nileshdas092006-hash/hardware_lab_shieldv/diagrams/timing_diagram.png

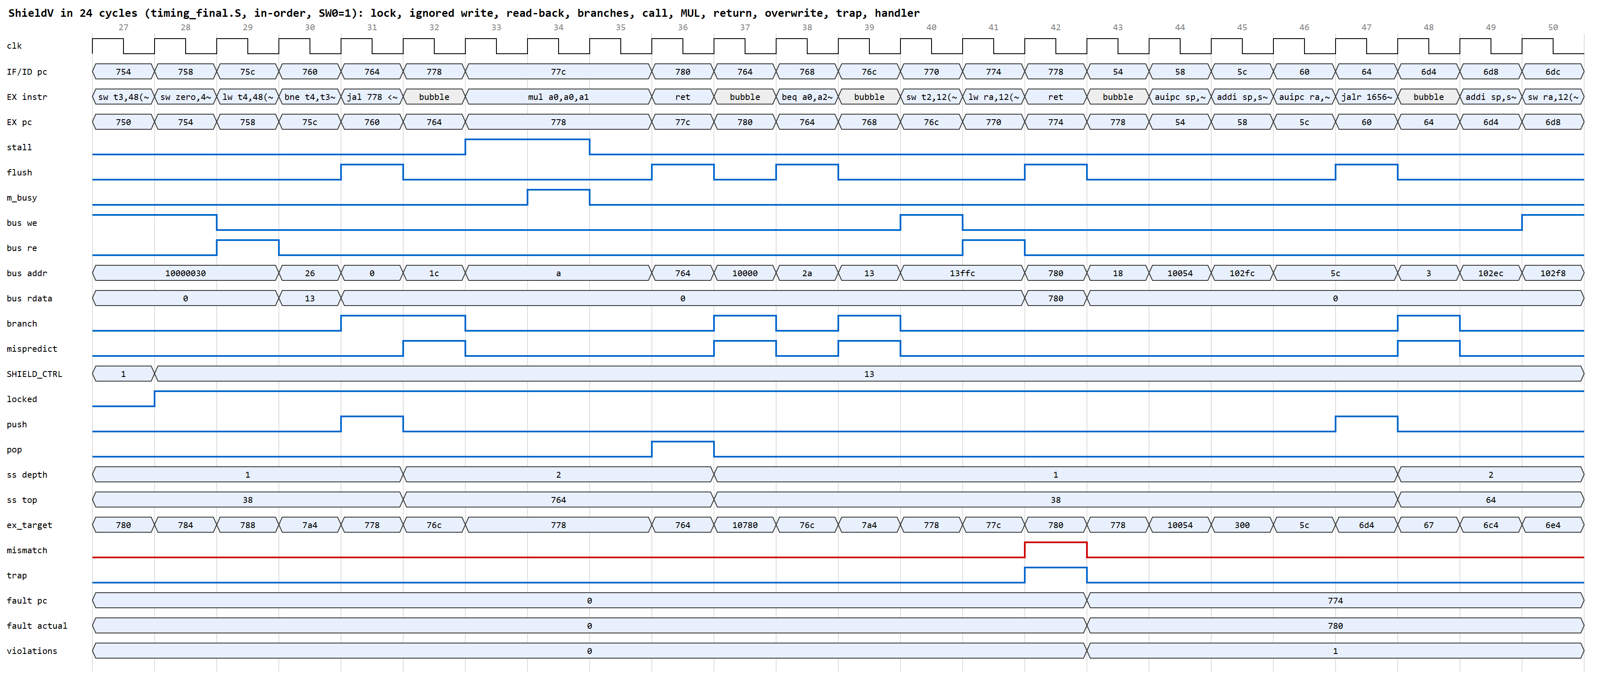
diagrams/timing_diagram.png
