nileshdas092006-hash/hardware_lab_shieldv/diagrams/top_block_diagram.png

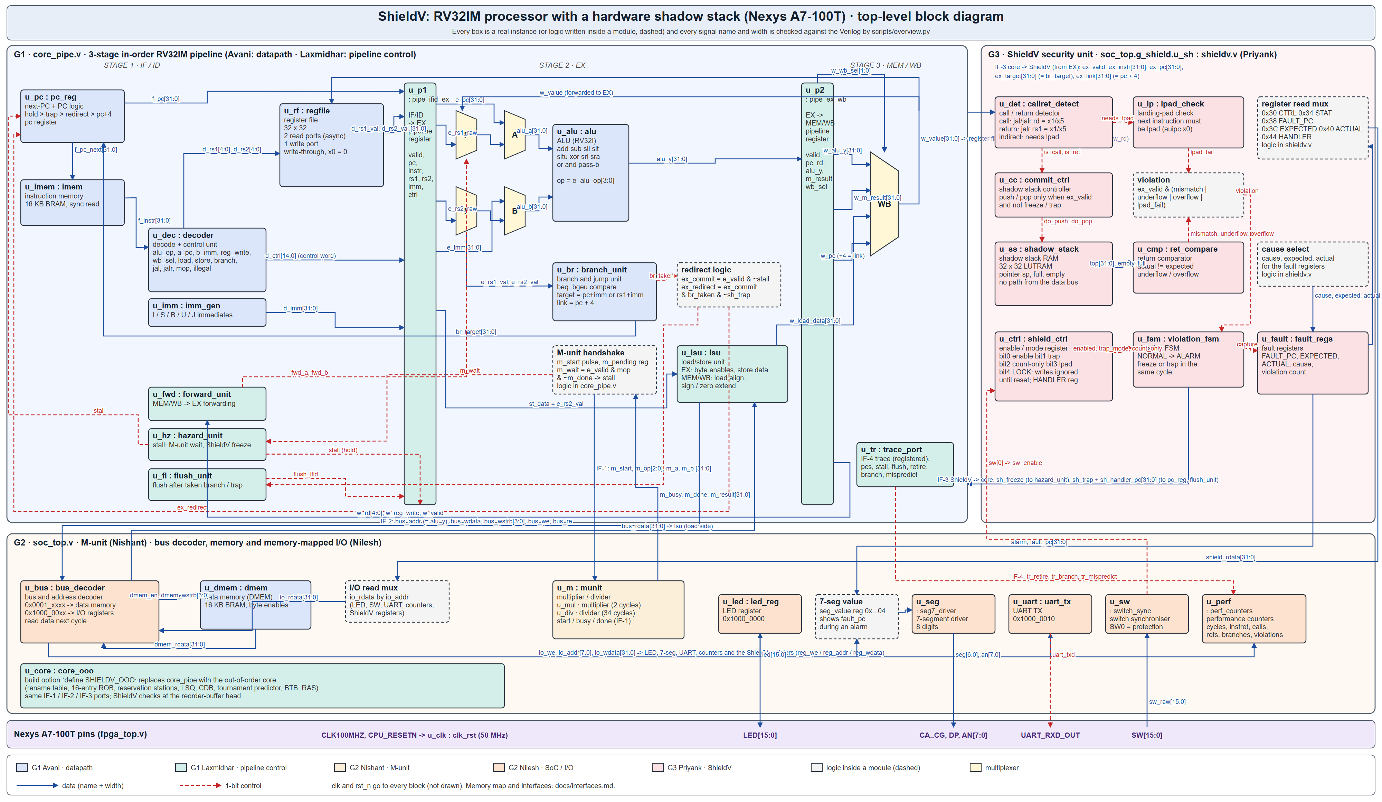
diagrams/top_block_diagram.png
