nileshdas092006-hash/hardware_lab_shieldv/docs/gantt_chart.png

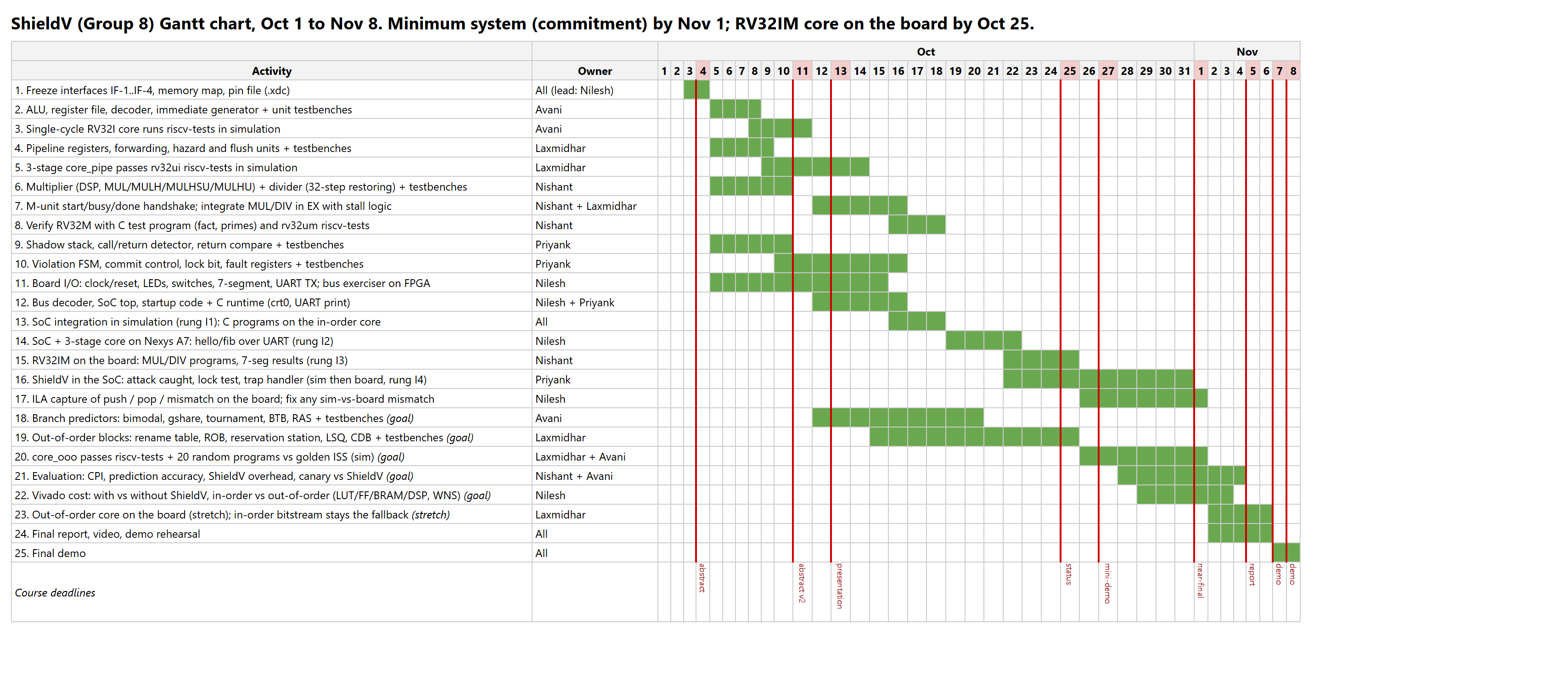
docs/gantt_chart.png
