nileshdas092006-hash/hardware_lab_shieldv/G1/Laxmidhar/ila_attack.png

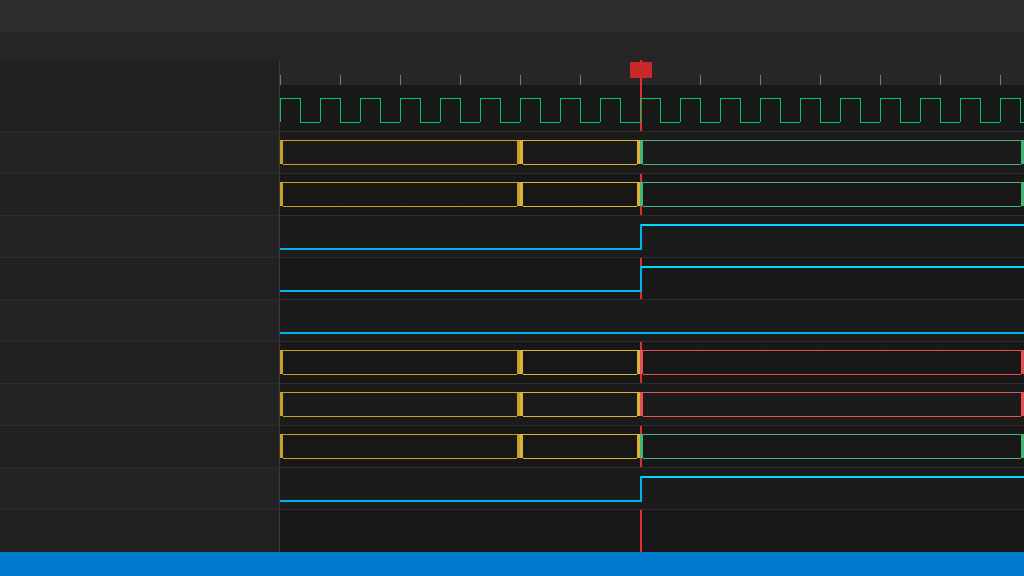
G1/Laxmidhar/ila_attack.png
