nileshdas092006-hash/hardware_lab_shieldv/docs/ShieldV_Build_Plan.html

CS2202L Hardware Lab · IIT Guwahati · Group 8 · Team of 5 · updated Oct 11 for the new abstract

# ShieldV Build Plan

An RV32IM processor that refuses to be hijacked, with two interchangeable cores: a 3-stage in-order pipeline (the committed baseline) and an out-of-order Tomasulo core (the extension), both protected by the same hardware shadow stack. Five people in three groups build against frozen interfaces and join one rung at a time, to the final demo (Nov 7–8).

Oct 4 abstractOct 11 abstract v2Oct 11 block diagramOct 13 presentationOct 25 statusOct 27 mini-demoOct 22 M3 SoC on FPGANov 1 M5 minimum system · near-finalNov 2–6 M6 out-of-order + evaluationNov 5 report + videoNov 7–8 final demo

ISA | RV32I + M (multiply/divide), bare metal
Cores | Build option: 3-stage in-order (IF/ID · EX · MEM/WB, default) or out-of-order Tomasulo (rename table, 16-entry ROB, reservation stations, load/store queue, CDB, tournament predictor, BTB, return-address stack). ShieldV checks returns from EX (in-order) or at ROB commit (out-of-order) over the same IF-3 wires
Security | Hardware shadow stack checks every function return; a lock bit makes the control and handler registers read-only after boot; landing pads for indirect jumps (goal). Inspired by the ratified RISC-V CFI extensions (Zicfiss / Zicfilp)
Board | Nexys A7-100T (Artix-7). Inferred from the course repo's pin constraints; confirm with the lab
Demo | Input: a C program with a hidden overflow + the protection switch. Processing: the core runs it while ShieldV checks every return. Output: off → LEDs show HACKED; on → trap before the first attacker instruction, red alarm LED, fault PC on the 7-segment display, UART report; a write to the locked control register is ignored. Either the in-order or the out-of-order bitstream can be loaded

Commitment · must work by Nov 1

- RV32IM 3-stage in-order pipeline on the FPGA, with forwarding, stalls and flushes
- 5+ C programs compiled with -march=rv32im, results on UART + 7-segment
- 32-entry shadow stack; trap handler reports faulting PC, expected and actual address on UART and the display
- SW0 turns protection on and off
- Lock bit: after boot code enables protection and locks, the control and handler registers ignore all writes until reset
- ShieldV's own clock and LUT cost, measured with and without it

Goal · Nov 2–6

- Out-of-order Tomasulo core (16-entry ROB, RS, LSQ, CDB, tournament predictor, BTB, RAS); ShieldV checks at commit; in-order build stays the fallback
- Landing-pad check for indirect jumps (forward edge, Zicfilp-inspired)
- Stack canaries (-fstack-protector) compared with ShieldV
- CPI of both cores; branch-prediction accuracy (≥ 85 %)
- Performance counters: cycles, instructions, branches, calls, returns, violations
- Three ShieldV safety properties proven with SymbiYosys; random programs vs a golden model

Stretch · if time remains

- Two-wide dispatch in the out-of-order core
- Decode the real Zicfiss instructions (sspush, sspopchk, ssrdp) and spill the shadow stack to protected memory
- Machine / user privilege modes

Design goal (for the abstract) | Target | How it is measured
Correctness | 100% rv32ui + rv32um, both cores | riscv-tests; workloads match a reference (Spike, or our golden model); random differential tests
Detection | 0 attacker instructions | Mismatch trapped before the redirect: simulation trace, ILA capture
Lock integrity | 0 changes after lock | Directed write tests; formal proof (planned)
Protection overhead | +0 cycles per call/return | Cycle counters with protection off/on; Vivado with vs without ShieldV
MUL / DIV latency | ≤2 / ≤34 cycles | Testbench cycle counts
Clock | ≥50 MHz in-order (target 100); out-of-order as measured | Vivado timing report
Out-of-order speed | ≥1.0× geomean vs in-order | CPI per workload from the performance counters
Branch prediction | ≥85% correct | BRANCHES and MISPRED counters
Resources | ShieldV ≤500 LUTs, 0 BRAM; SoC ≤25% (15,850 LUTs) | Vivado utilization report
Security correctness | 0 false alarms, 100% injected caught | Test matrix, fault injection, canary comparison

Where the code is on Oct 11. Everything in the commitment tier and most of the goal tier is written and passes in simulation on the lab laptop (Vivado xsim): the lock bit, both cores (48/48 riscv-tests each), all C programs and attacks on both cores, random programs against a golden model, the canary comparison and the CPI / prediction study. Still to do: everything on the real board (needs the lab), the SymbiYosys proofs (tool not installed), Spike runs (tool not installed) and all stretch goals. Live numbers: docs/results/README.md. Diagrams: diagrams/top_block_diagram.svg and diagrams/timing_diagram.svg.

Every block, one picture

## The system map

Each box is one block you will build and test on its own. Colour shows which module owns it; the border shows its tier. Click any block (or any row in the module lists below) to see what it does, why it exists, how you prove it works and what to read first.

G1 · Core (Avani, Laxmidhar) G2 · RV32M + SoC (Nishant, Nilesh) G3 · ShieldV hardware (Priyank) G3 · Software (Priyank) solid = commitmentdashed = goaldotted = stretch

Built in parallel, Oct 5 – Nov 1

## Three groups, five owners

Each person owns one module end to end: the RTL, its testbenches and its explanation in the viva. They can be built at the same time because nobody waits on anybody: the connections between modules are frozen on day one as interface contracts, and every module is tested against stubs and its own testbench before it ever meets the others.

### The interface contracts (frozen Oct 4, logged changes Oct 11)

These four port lists are the only things the modules share. Write them into docs/interfaces.md and a header file before any RTL. Changing one needs every owner of that interface to agree, with a line in the decision log.

// IF-1  Core <-> M-unit  (owner B implements, A calls)
input  start, input [2:0] op /*funct3*/, input [31:0] a, b,
output busy, output done, output [31:0] result
// rule: core stalls while busy; result valid when done=1 (1 cycle)

// IF-2  Core <-> Data bus  (A drives, B decodes)
output [31:0] addr, wdata, output [3:0] wstrb, output we, re,
input  [31:0] rdata            // available the next cycle

// IF-3  Core <-> ShieldV  (G1 exports, G3 consumes)
// in-order: from EX; out-of-order: from the ROB head at commit
output ex_valid    // real instruction, committing this cycle
output [31:0] ex_instr, ex_pc, ex_target, ex_link /*pc+4*/
input  sh_freeze, sh_trap, input [31:0] sh_handler_pc

// IF-4  Trace port  (A exports, B/C observe)
output [31:0] if_pc, ex_pc, wb_pc, output stall, flush, ex_valid,
output retire, branch, mispredict   // branch/mispredict added Oct 11

### Memory map (owned by B, used by C's software)

0x0000_0000  IMEM   16 KB  program (.text)
0x0001_0000  DMEM   16 KB  data + stack, sp = 0x0001_4000
0x1000_0000  LED          write 16 bits
0x1000_0004  SEG7         write 32 bits (8 hex digits)
0x1000_0008  SWITCH       read 16 bits (synchronised)
0x1000_0010  UART_TX      write 1 byte
0x1000_0014  UART_STATUS  bit0 = busy
0x1000_0020  CYCLE        read, cycles since reset
0x1000_0024  INSTRET      read, instructions retired
0x1000_0028  CALLS / _2C RETS
0x1000_0030  SHIELD_CTRL  bit0 enable, 1 trap, 2 count-only, 3 lpad, 4 LOCK
0x1000_0034  SHIELD_STAT  violations, depth, cause, [30] locked, [31] alarm
0x1000_0038  FAULT_PC / _3C EXPECTED / _40 ACTUAL / _44 HANDLER
0x1000_0050  BRANCHES / _54 MISPRED / _58 VIOL / _5C CORE_ID

Why memory-mapped I/O: C code lights an LED or prints a character with an ordinary store instruction. No new instructions are needed, so the I/O can be built and tested without the CPU.

Joining the modules, Oct 16 – Nov 6

## The integration ladder

Integration happens one rung at a time. Each rung swaps exactly one set of stubs for real blocks and has one gate test. If a rung fails you go back one rung, never more, because everything below it was already proven.

Week by week

## The five-week roadmap

Rows are people; the integration row is shared. The course's own deadlines sit on the bottom row so every weekly report has a finished thing to show.

Critical path: G1. If the in-order pipeline slips, everything slips; the out-of-order core is joined only after the minimum system works, and the in-order bitstream is always the fallback. The out-of-order core's clock speed is the main open risk.

Know the answer before the AI writes the code

## What correct looks like

This picture is a hand-drawn prediction, made before the RTL existed, to practise reading timing. The real one, cut from simulation of the actual Verilog (lock, ignored write, read-back, branches, call, MUL stall, return, overflow, trap and the handler starting, in 24 cycles), is diagrams/timing_diagram.svg. This is the attack caught cycle by cycle in your 3-stage pipeline. victim() is called from 0x100, its store overflows the saved return address with 0x300 (the hacked() function), and the return is caught in EX at cycle 8. If you can predict a picture like this before simulating, you can catch AI mistakes.

### How to read it

Cycle 2: jal ra reaches EX, is a call, pushes 0x104. The instruction fetched behind it (0x104) is flushed, so cycle 3 has a bubble in EX. Cycle 5: the overflowing store writes 0x300 over the saved return address in data memory, which ShieldV cannot see and does not need to. Cycle 8: ret wants to jump to 0x300 but the shadow copy says 0x104, so mismatch rises, the redirect is blocked and from cycle 9 the pipeline is frozen. With protection off, cycle 9 would fetch 0x300 and the LEDs would read HACKED.

### The two graded scenarios (≥25 cycles each)

Scenario 1, normal execution: nested calls in recursive Fibonacci with shadow-stack pushes and pops, a load-use stall, forwarding, a taken branch flush and a 34-cycle DIV stall.

Scenario 2, attack: the sequence above stretched to 25+ cycles, plus the trap to the handler (goal tier).

The course says timing diagrams must reflect actual execution. So generate both from your simulation VCD (WaveDrom), and capture Scenario 2 on the board with the ILA as proof.

Antigravity + Claude Code, set up for hardware

## The AI build environment

Five layers, set up once on Oct 4–5 by all five of you so everyone's machine behaves the same. The AI writes most of the code. These layers make sure what it writes is checked by tools and understood by you.

Layer 1Machine

- Laptop + Nexys A7 over USB (programming and UART on the same cable).
- Windows: Vivado runs natively; install WSL2 Ubuntu for the open-source tools and run Claude Code there. Linux: everything native.

Layer 2Hardware tools

- Vivado ML Standard (free, supports Artix-7 100T): synthesis, bitstream, ILA on-board debugging, utilization and timing reports.
- Icarus Verilog for fast unit simulation, Verilator --lint-only for catching bugs before simulation, Verible for formatting.
- GTKWave or Surfer to look at waveforms; WaveDrom + vcd2wavedrom to turn a VCD window into a report-quality timing diagram.
- xPack riscv-none-elf-gcc (14.x or newer) to compile C for rv32im; Spike as the official reference simulator; Ripes to watch C run on a visual pipeline while learning.
- draw.io for block diagrams, Yosys + netlistsvg to auto-draw a schematic from your RTL and cross-check the diagram; Python 3 + pyserial for scripts and reading UART.

Layer 3IDE

- Antigravity opens the repo. Install the Claude Code extension from Open VSX (search "Claude Code"), or run claude in Antigravity's terminal. The official docs list both routes for VS Code forks.
- From Open VSX also add a Verilog syntax extension and a Draw.io integration so diagrams live in the repo next to the code.
- Split of AIs: Claude Code is the only writer of RTL, testbenches and scripts. Antigravity's built-in agent is the second opinion: reviewing a diff, researching a spec question, drafting a diagram. Two agents never edit the same folder at once.

Layer 4Project brain

- CLAUDE.md: project goal, ownership, Verilog rules, commands. Claude reads it every session.
- .claude/agents/: rtl-reviewer, tb-writer, viva-coach subagents (below).
- .claude/skills/: timing-diagram, new-block, fpga-build, each a repeatable recipe.
- .claude/settings.json: a hook that lints the RTL after every AI edit and sends errors back to Claude.

Layer 5Safety net

- Private GitHub repo; one branch per block; the module owner reviews every merge into their folder.
- GitHub Actions runs make lint test on every push, so a broken block can never sit silently in main. The run history doubles as progress evidence.
- MCP servers are optional here. Nothing in this project needs one; hooks, subagents and CI matter far more.

### Repository layout

hardware_lab_shieldv/          (the real layout, Oct 11)
├─ G1/ Avani/ Laxmidhar/   rtl/ tb/ golden/   core, predictor, out-of-order engine
├─ G2/ Nishant/ Nilesh/    rtl/ tb/ golden/   M-unit; SoC (Nilesh also fpga/)
├─ G3/ Priynk/             rtl/ tb/ golden/ sw/   ShieldV + all C software
├─ diagrams/               top_block_diagram.svg/.png · timing_diagram.svg/.png
├─ docs/                   interfaces.md · PROVENANCE.md · results/ · how-to-commit.md
├─ scripts/                run_tests · run_prog · riscv_tests · random_diff · rv32im_iss · measure · canary · diagrams · fpga
└─ .github/workflows/sim.yml

### CLAUDE.md starter

# ShieldV: RV32IM core with a hardware shadow stack
3-stage pipeline (IF/ID, EX, MEM/WB) on Nexys A7-100T.
ShieldV checks every return against a hardware shadow stack.
Read docs/interfaces.md before touching any port.
Interfaces are frozen; changes need all 3 owners (log in docs/decisions/).

## Ownership (one writer per folder)
rtl/core, rtl/mem          -> Member A
rtl/munit, rtl/soc, fpga   -> Member B
rtl/shield, sw             -> Member C

## Verilog rules
- Verilog-2001, one module per file, file name = module name
- Sequential: always @(posedge clk) with <= ; combinational: always @* with =
- Every register has a synchronous active-low reset (rst_n)
- No latches: assign every combinational output a default first
- Explicit widths on constants (32'd4, not 4)

## Commands
make lint | make test | make sim PROG=fib
make diagrams | make fpga

## We are learning
- Before writing a block, ask for the golden I/O table in docs/golden/.
- After a block, add 5 plain-language lines to docs/learning-log.md.
- Never call something done unless make test passes.
- Never edit a test just to make it pass.

### Lint hook · .claude/settings.json

{
  "hooks": {
    "PostToolUse": [
      {
        "matcher": "Edit|Write",
        "hooks": [
          {
            "type": "command",
            "command": "make -s lint 2>lint.log >/dev/null || { cat lint.log >&2; exit 2; }"
          }
        ]
      }
    ]
  }
}

After every file edit, Claude Code runs the linter. For PostToolUse, exit code 2 shows the error text to Claude, so it fixes latches and width mismatches immediately.

### Subagent · .claude/agents/viva-coach.md

---
name: viva-coach
description: Quizzes a team member on a block they built,
  one question at a time. Use when asked "quiz me on <block>".
tools: Read, Grep, Glob
---
Read the block's RTL, testbench and docs/learning-log.md.
Ask 5 questions an examiner would ask, easy to hard.
Wait for each answer. Correct it in plain language,
pointing to the exact line of RTL. End with the one
concept the student should revise.

### Subagent · rtl-reviewer.md

---
name: rtl-reviewer
description: Reviews Verilog changes for latches, blocking vs
  non-blocking misuse, missing resets, width mismatches and
  violations of docs/interfaces.md. Use after any RTL edit.
tools: Read, Grep, Glob, Bash
---
Report findings as a numbered list: file:line, the problem,
one plain-language sentence on why it breaks on FPGA.
Do not edit files.

### Skill · .claude/skills/timing-diagram/SKILL.md

---
name: timing-diagram
description: Turn a window of a simulation VCD into a
  WaveDrom timing diagram for reports.
---
1. make sim PROG=<prog>  -> build/<prog>.vcd
2. Pick a window of at least 25 cycles around the event.
3. scripts/vcd2wave.py with the signal list in scripts/diagrams.py
4. Write diagrams/timing_diagram.svg (and a .png copy)
5. Write a caption naming every stall, flush, push, pop.

### Tool → job → marks

Tool | Job in ShieldV | Marks it supports
Vivado + ILA | Bitstream, resource and timing numbers, watching real signals on the board | FPGA demo 2.5 · Design 1.0
Icarus + Verilator | Run every unit testbench in seconds; lint catches latches and width bugs early | Validation 1.0
Spike + riscv-tests | Independent "right answer" for every instruction and program | Validation 1.0
WaveDrom + vcd2wavedrom | Timing diagrams cut from real simulation | Timing diagram 1.5
draw.io + netlistsvg | Clean block diagrams, checked against what the RTL actually contains | Block diagram 1.0
Git + GitHub Actions | Small commits per block per person; CI history shows steady progress | Git 1.0 · Progress 1.0
Ripes + Compiler Explorer | See how your C becomes RISC-V and flows through a pipeline | Viva and understanding

Understand it while the AI builds it

## The learning loop, study library and viva bank

Run this loop for every block. Step 2 is the important one: you write down what the block should do before the AI writes it. When the simulation disagrees with your prediction, either the AI or your understanding is wrong, and finding out which is exactly the learning.

Learn

20 minutes on the block's study link from the map.

Predict

Write the golden input/output table and sketch the expected waveform by hand in docs/golden/.

Generate

Claude Code in plan mode: approve the plan and test cases first, then the RTL and testbench.

Prove

Lint hook, make test, compare against your prediction. Investigate every difference.

Explain

viva-coach asks 5 questions; add 5 lines to the learning log.

Commit

Separate commits for test, RTL, fix and docs. That adds up to 20+ per person without trying.

Example prompt (plan mode):
Build block C2, the shadow stack RAM. Contract: docs/interfaces.md IF-3.
Golden I/O: docs/golden/C2.md. Show me the plan and the testbench cases first;
do not write RTL until I approve. Use LUTRAM with asynchronous read.
Explain every design choice in one plain sentence.

### Study library

### Viva question bank

Every member should be able to answer all of these, not just the ones about their own module.

Built against the grading sheet

## Marks map and risks

Every component of the 10-mark scheme has a planned piece of evidence. Reminder from the guidelines: no marks at all without a block diagram and an FPGA demo, and each student must implement at least one hardware module and explain their own code.

Component | Marks | Evidence ShieldV produces | Ready by
Block diagram | 1.0 | diagrams/top_block_diagram.svg: the whole system with every sub-block, signal names and widths checked against the Verilog | Oct 11
Timing diagram | 1.5 | One 24-cycle timing diagram of the whole project cut from a real simulation VCD (lock, ignored write, read-back, branches, call, MUL stall, return, overflow, trap, handler start); ILA capture on the board still to do | Oct 11 sim · Nov 1 board
Design | 1.0 | Interface contracts, decision log, FSM diagrams for the divider, UART and violation FSM | Oct 11
Validation | 1.0 | 37 unit testbenches, riscv-tests on both cores, random programs vs a golden model on both cores, workloads, attack / lock / canary matrix, shield replay, CI history; formal proofs planned | Nov 1
Demo video | 1.0 | 4 minutes: 30 s problem, 60 s architecture, 100 s live switch-off/switch-on demo, 50 s results | Nov 5
FPGA demo | 2.5 | Demo runbook, rehearsed twice; backup bitstreams for rungs I3 and I4 | Nov 7–8
Regular progress | 1.0 | Weekly reports, each pointing at one finished rung or block | weekly
Git commits | 1.0 | Commit plans: Avani 32, Laxmidhar 33, Nishant 24, Nilesh 35, Priyank 41 commits (all ≥ 20), each from the member's own account | continuous

### Risk register

Risk | What it would cost | Built-in answer | Owner
Pipeline slips | Everything downstream waits | Single-cycle core first; stubs let B and C keep moving | A
Works in sim, fails on board | The 2.5-mark demo | Reset every register, synchronise switches, prove I/O on the board in week 2 before the CPU, ILA probes ready | B
Timing fails at 100 MHz | Random wrong results | Run at 50 MHz from a clock wizard; divider is multi-cycle anyway | B
Attack doesn't reproduce | No "before" picture in the demo | Prove it in week 1 on Ripes/Spike; compile with -O0, mark functions noinline, read the objdump for the exact stack offset | C
False alarms on normal code | Workloads freeze | No setjmp/longjmp in workloads; handle the coroutine swap case; "count only" mode for diagnosis; document the limitation | C
Recursion deeper than 32 | Overflow alarm | Overflow flag + bounded workload depth; spill is a stretch goal | C
AI code nobody understands | Viva marks; each student must explain their code | The learning loop, golden I/O written by a human, viva-coach before every report | All
Merge conflicts, uneven commits | Git marks, lost work | One writer per folder, one branch per block, CI on every push | All
Out-of-order core misses timing | No out-of-order bitstream | It is a build option: the in-order bitstream is the fallback; report the measured clock honestly | Laxmidhar, Nilesh
Out-of-order core slower than in-order | Misses the ≥1.0× goal | Measured per workload by measure.py; ideas in the report: fix mispredictions at execute, store-to-load forwarding | Laxmidhar, Avani
Formal tools not installed | No proofs | Install SymbiYosys (OSS CAD Suite) early; directed tests already cover the same three properties | Priyank

The whole method on one screen

## The ShieldV framework

Five rules that hold for every block, every rung and every person, plus the definition of done every block must meet before anyone builds on it.

Contract first

Ports and memory map frozen before any logic. This is what makes parallel work possible.

Predict before generate

A human writes the expected answer; the AI writes the code; the testbench decides who is right.

Stub to start early

Every module runs against fake neighbours from day one, so nobody waits.

One rung at a time

Join one set of real blocks per step, each with a single gate test; every rung after I1 ends on the board.

Explain to own

If you can't explain a block to viva-coach, it isn't done, however green the tests are.

Done check 1Golden I/O table written by the owner in docs/golden/

Done check 2Unit testbench passes in Icarus; Verilator lint clean

Done check 3Synthesises in Vivado with no latches or critical warnings

Done check 4Diagram and learning-log entry updated

Done check 5Owner answers viva-coach's 5 questions without help

The order of everything: Oct 4 freeze contracts → Oct 5–25 blocks in parallel (M1, M2, M4) → Oct 16–Nov 1 climb rungs I1 to I4 (M3 Oct 22) → Nov 1 minimum system with lock and trap on the board, out-of-order core passing riscv-tests in simulation (M5) → Nov 2–6 out-of-order on the board, evaluation, proofs (M6) → Nov 5 report and video → Nov 7–8 demo.

References used to build this plan

## Sources
