nileshdas092006-hash/hardware_lab_shieldv/(commit log)

2026-10-11 Add clock/reset, LED register and switch synchroniser with tests
    [clk_rst.v, io_regs_tb.v, led_reg.v, rst_sync.v, switch_sync.v]
2026-10-11 Add 7-segment driver and UART transmitter with tests
2026-10-16 test(imm): check immediates against assembler output
2026-10-16 feat(core): wire the single-cycle RV32IM core
2026-10-24 mini runtime(UART print,counters,LEDs)
2026-10-24 commit-log comparison with Spike;commit logs into call/return traces;shadow-stack model
2026-10-24 landing pad and function pointer test;timing1->short recursive program
    [fnptr.c, timing1.c]
2026-10-24 docs(div): trace 13 / 3 through restoring division by hand
2026-10-24 feat(div): implement 32-step restoring divider with sign fix-up
    [divider.v]
2026-10-25 ShieldV block and landing pad check
2026-10-27 docs(plan): add the Gantt chart
    [gantt_chart.xlsx]
2026-10-27 docs(munit): matrix multiply and primes on the board
2026-10-28 docs(pipeline): add expected waveforms for stall, flush and forward
2026-10-29 test(pipe): check stall holds and flush makes a bubble
    [pipe_regs_tb.v]
2026-10-30 feat(hazard): add central stall unit (M-unit busy, ShieldV freeze)
    [hazard_unit.v]
2026-10-30 feat(flush): flush wrong-path instruction on taken branch or trap
    [flush_unit.v]
2026-10-30 test(hazard): test forwarding, stall and flush decisions
    [hazard_tb.v]
2026-10-30 feat(trace): add trace port (IF-4)
2026-10-31 feat(core): wire the 3-stage pipelined core
2026-10-31 test(core): add directed hazard program in assembly
2026-10-31 test(core): run hazards.S on the pipeline and count stalls/flushes
    [core_pipe_tb.v]
2026-11-01 docs(timing): add ILA capture of the attack on the board
2026-11-02 docs(rob): trace the same program through the ROB by hand
2026-11-04 feat(ooo): wire the out-of-order core with the same ports as core_pipe
2026-11-05 build(lint): print Verilator warnings without failing CI
2026-11-07 fix(ras): wrap the top index on all simulators; add demo runbook and core selection
    [attack.c, ras.v]
2026-11-07 feat(demo): choose any function and value on the board with the switches
